SekouAgard/Door-Opener/Door Opener.f3d v8.stl

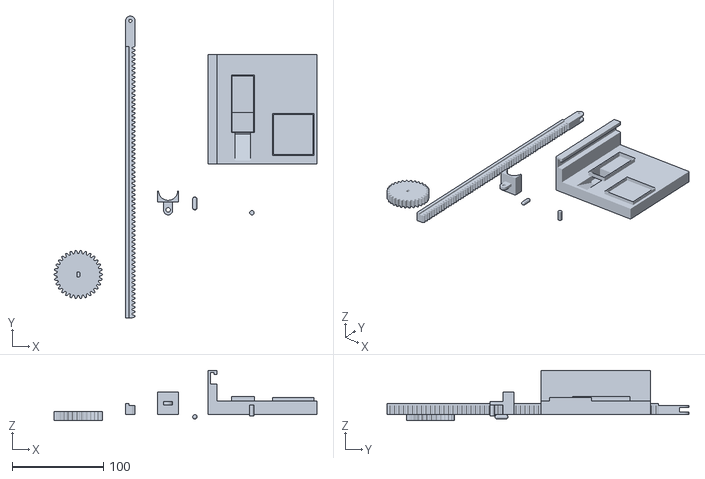
[picture p1: CAD file, 2024-04-30]
Door Opener.f3d v8.stl
288.9 x 331.6 x 55.0
